Swimnato/SplitKeyboard/README.md

# SplitKeyboard
Split keyboard with rotary encoder using the Nice!Nano V2
