Swimnato/SplitKeyboard/simulation_image_bottom V1.png

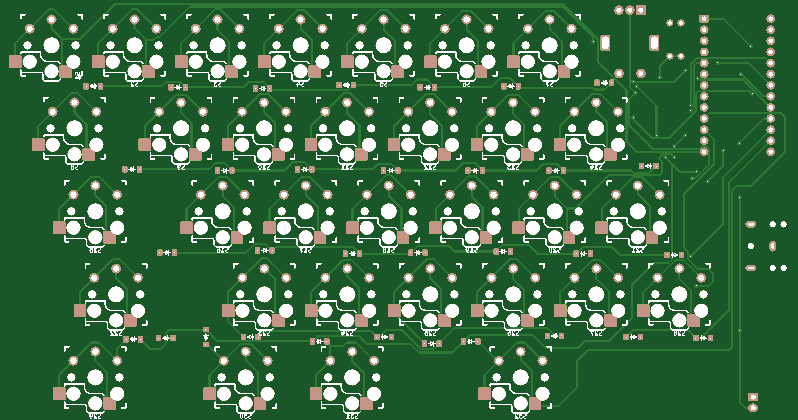
simulation_image_bottom V1.png
