Swimnato/SplitKeyboard/simulation_image_bottom V2.png

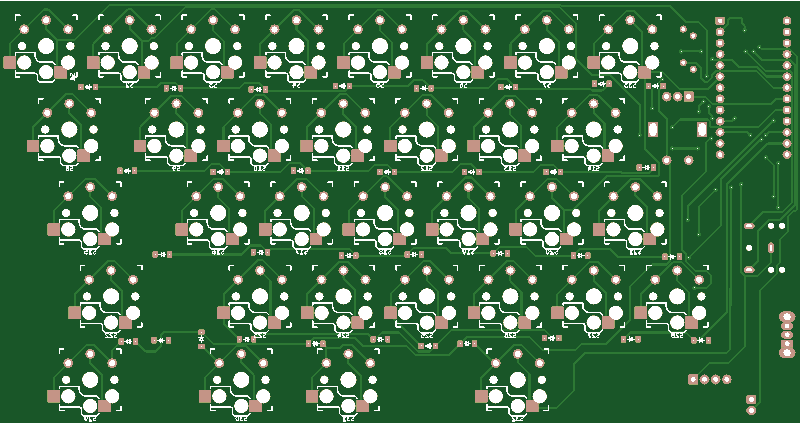
simulation_image_bottom V2.png
