Swimnato/SplitKeyboard/simulation_image_top V1.png

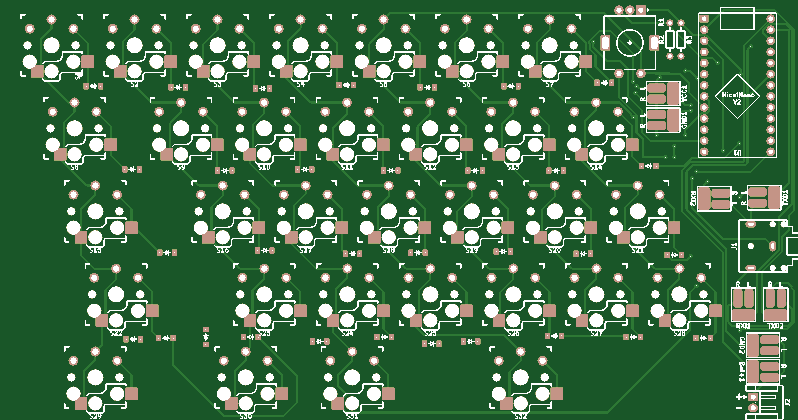
simulation_image_top V1.png
