Swimnato/SplitKeyboard/simulation_image_top V2.png

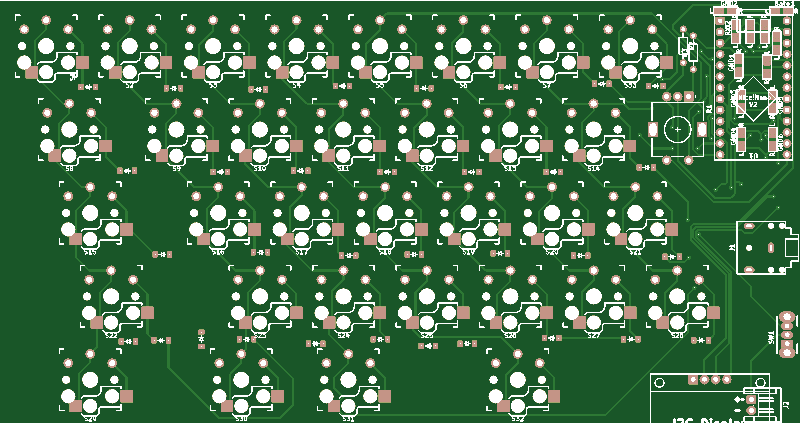
simulation_image_top V2.png
