Swimnato/SplitKeyboard/Parts List.xlsx

Pieces for my Custom Keyboard
Part | Quantity | Link | Price: | Alt Link | Price: | Alt-Alt Link | Price: | Notes
Hot swap Sockets | > 68 to be safe | https://www.amazon.com/DUROCK-Mechanical-Keyboard-Switches-Hot-Swap/dp/B0B4W9YMGM | 13.99 (Pack of 110) |  |  |  |  | You can order these in bulk with the rest of the club, they are the same footprint
Nice!Nano V2 W/ Bluetooth | 2 | https://www.amazon.com/AITRIP-Development-Bluetooth-Management-Module%EF%BC%8CNano/dp/B0DCZJKYL1?s=electronics | 15.99 (Pack of 2) | https://www.amazon.com/AITRIP-Development-Bluetooth-Management-Module%EF%BC%8CNano/dp/B0DCZM8DS9?s=electronics | 21.99 (Pack of 4) | https://www.ebay.com/itm/335573108896?_skw=NRF52840&itmmeta=01JBGAV2F2A7GKGRMNT59WB6JM | 5.63 | It is cheaper on ebay, though the 4 pack on amazon is a little cheaper, so if someone else is using a pro micro compatible pinout they could use this as a drop in replacement so that shipping is fast and we keep costs down, if not ebay from china is sometimes a gamble on how long it takes, or the two pack from amazon is a few dollars more, and is the same site
Diodes | > 69 to be safe | https://www.digikey.com/en/products/detail/onsemi/1N4148TR/9356376 | 0.015 (1.5 cents) |  |  |  |  | Just get me whatever the club is getting, for a pack of 1,000 here on digikey they are like 1.5 ¢ a pop and they are through-hole and will be less of a headache to solder.
Audio Jack | 2 | https://www.amazon.com/uxcell-6-35mm-Headphone-Stereo-Socket/dp/B00X77SUJQ?s=electronics | 6.99 (Pack of 10) |  |  |  |  | I think this is the right footprint… I just used what Carter told me to use, so maybe it would be best to consult with him about this piece…
Power Switch | 2 | https://www.amazon.com/Uxcell-a15080400ux1036-Position-Switch-0-28000000000000003/dp/B0159MD4LU | 9.90 (Pack of 10) | https://www.ebay.com/itm/323745283211?_skw=spdt+switch+slide+horizontal&itmmeta=01JBGBPVZ60JGZ255SN21QV7CC | 6.19 (Pack of 20) |  |  | Just a side-mounted slider switch. I decided to go with through hole, and carter chose SMD, so this part matters.
JST Connector for Battery | 2 | https://www.ebay.com/itm/335543114318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 | 1.99 (Pack of 20) |  |  |  |  | Just whatever Carter is using for the rest. No amazon link for this one, because they, like the diodes on amazon only have variety packs, they are not sold individually.
Rotary Encoder | 2 | https://www.amazon.com/DIYhz-Rotary-Encoder-Digital-Potentiometer/dp/B07D3DF8TK?cv_ct_cx=rotary+encoder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 | 10.99 (Pack of 10) | https://www.ebay.com/itm/203080834192?_skw=rotary+encoder&itmmeta=01JBGC89KK99RV9GBNWEZ2VFHP&var=503312093055 | 2.70 (Pack of 5) |  |  | Regular old Rotary encoder, 10 pack from amazon if others are using them too, if not then ebay is probably better.
Knob for Rotary Encoder | 2 | https://www.ebay.com/itm/126592891723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 | 1.66 | https://www.ebay.com/itm/134047196263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 | 2.69 (Pack of 10) | https://www.amazon.com/Aluminum-Electronic-Potentiometer-Diameter-Knobs%EF%BC%8CSwitch/dp/B08GK8GK72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 | 13.99 (Pack of 5)
I2C Display | 1 | https://www.amazon.com/HiLetgo-Serial-128X64-Display-Color/dp/B06XRBTBTB?s=electronics | 6.99 | https://www.ebay.com/itm/235685702270?_skw=ssd+1306&itmmeta=01JBGCYAW0TF2XEKN1HQ1EHMS6&var=535999986417 | 1.92
10K pullup resistors | 2 | https://www.digikey.com/en/products/detail/stackpole-electronics-inc/CF14JT10K0/1741265 | 0.1 |  |  |  |  | Getting them from the ECE shop would also be fine.
Choc Switches | 68 | https://www.amazon.com/Mechanical-Keyboard-switches-Chocolate-Switches/dp/B0DDCG2WJF | 42.99
PCB cost with shipping: | ~$30
SUBTOTAL of switches, PCB and hotswap brackets (Price divided by packs since spare parts can be reused)
81.64
As you can see, this is the bulk of the price! And this doesn't even include a microcontroller, diodes, rotary encoder or anything!
Subtotal of other components (Price divided by packs, because spare parts can be reused)
$20.11
Many of these parts can be purchased from the ECE shop in smaller quantities while maintining the bulk discount, with how the shop works.
The only parts I think will need to be purchased externally will be the Nice!Nanos, I2C Display,Choc Switches, PCB, rotary encoer and knob and Hot
Swap sockets.
