Swimnato/SplitKeyboard/3d Models/Decor Plate.stl

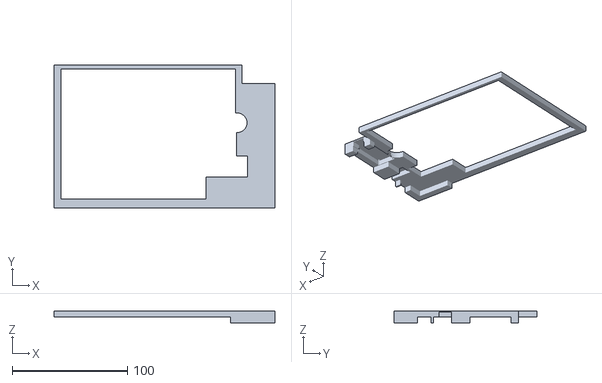
[picture p5: CAD file, 2025-01-26]
3d Models/Decor Plate.stl
191.8 x 124.2 x 10.4
