Swimnato/SplitKeyboard/PCB Bare.stl

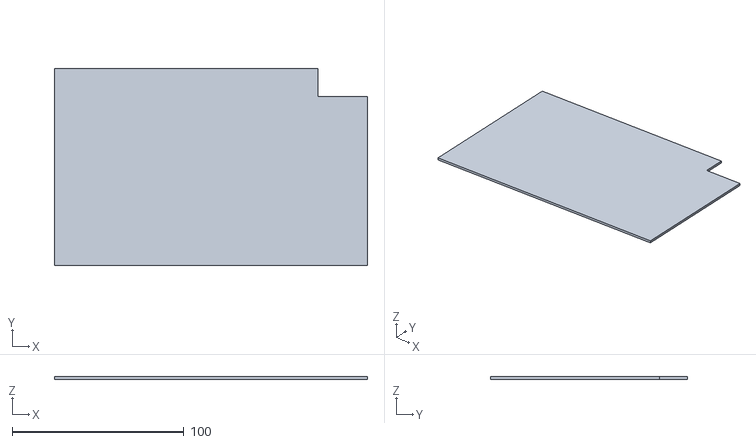
[picture p6: CAD file, 2025-01-17]
PCB Bare.stl
182.1 x 114.5 x 1.60
