Swimnato/SplitKeyboard/3d Models/Keyboard Case.3mf

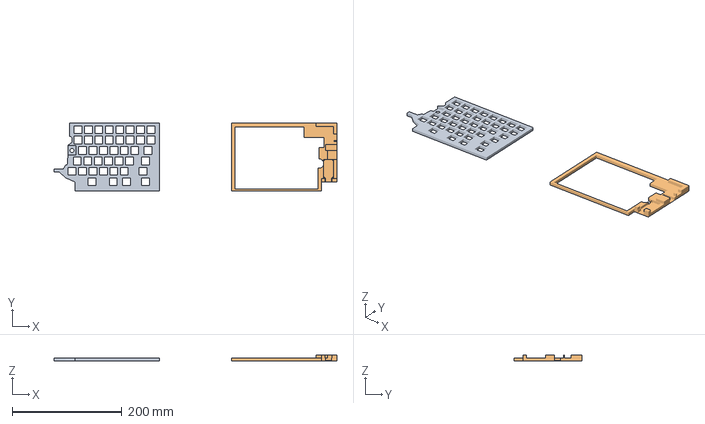
[picture p7: CAD file, 2025-01-26]
3d Models/Keyboard Case.3mf
515.1 x 124.2 x 10.4 mm
Key Plate.stl
Decor Plate.stl
