Swimnato/SplitKeyboard/3d Models/Key Plate.stl

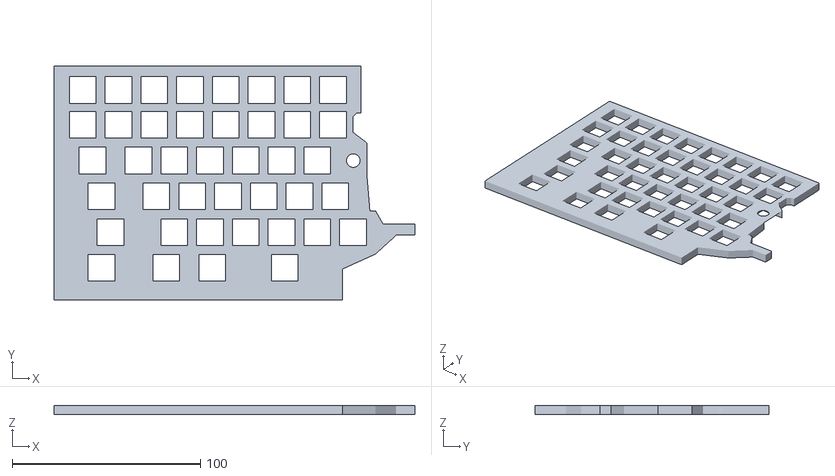
[picture p8: CAD file, 2025-01-26]
3d Models/Key Plate.stl
191.8 x 124.2 x 5.00
