Swimnato/SplitKeyboard/simple_split_MX.step

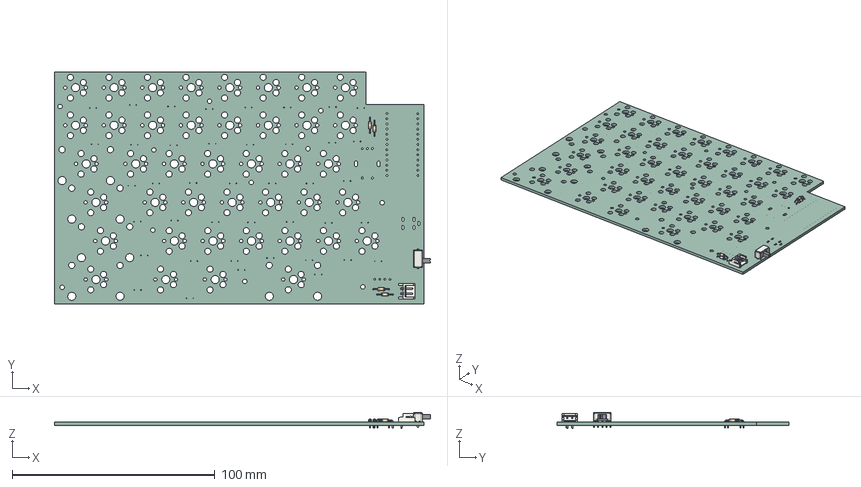
[picture p9: CAD file, 2025-01-17]
simple_split_MX.step
185.3 x 114.5 x 7.90 mm
R_Axial_DIN0204_L36mm_D16mm_P762mm_Horizontal x 4
JST_S2B_EH
SW_Slide_SPDT_Angled_CK_OS102011MA1Q
simple_split_MX_PCB
