Swimnato/SplitKeyboard/3d Models/Bottom Case.stl

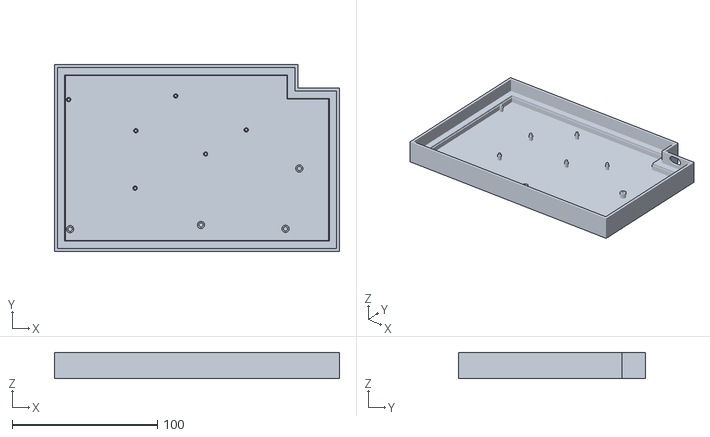
[picture p10: CAD file, 2025-01-17]
3d Models/Bottom Case.stl
196.1 x 128.5 x 18.1
