Swimnato/SplitKeyboard/(list of files, cad)

Other CAD files:
feecad test.FCStd
