Swimnato/SplitKeyboard/simple_split_MX.kicad_pcb

## KiCad design simple_split_MX.kicad_pcb (2024-11-22)

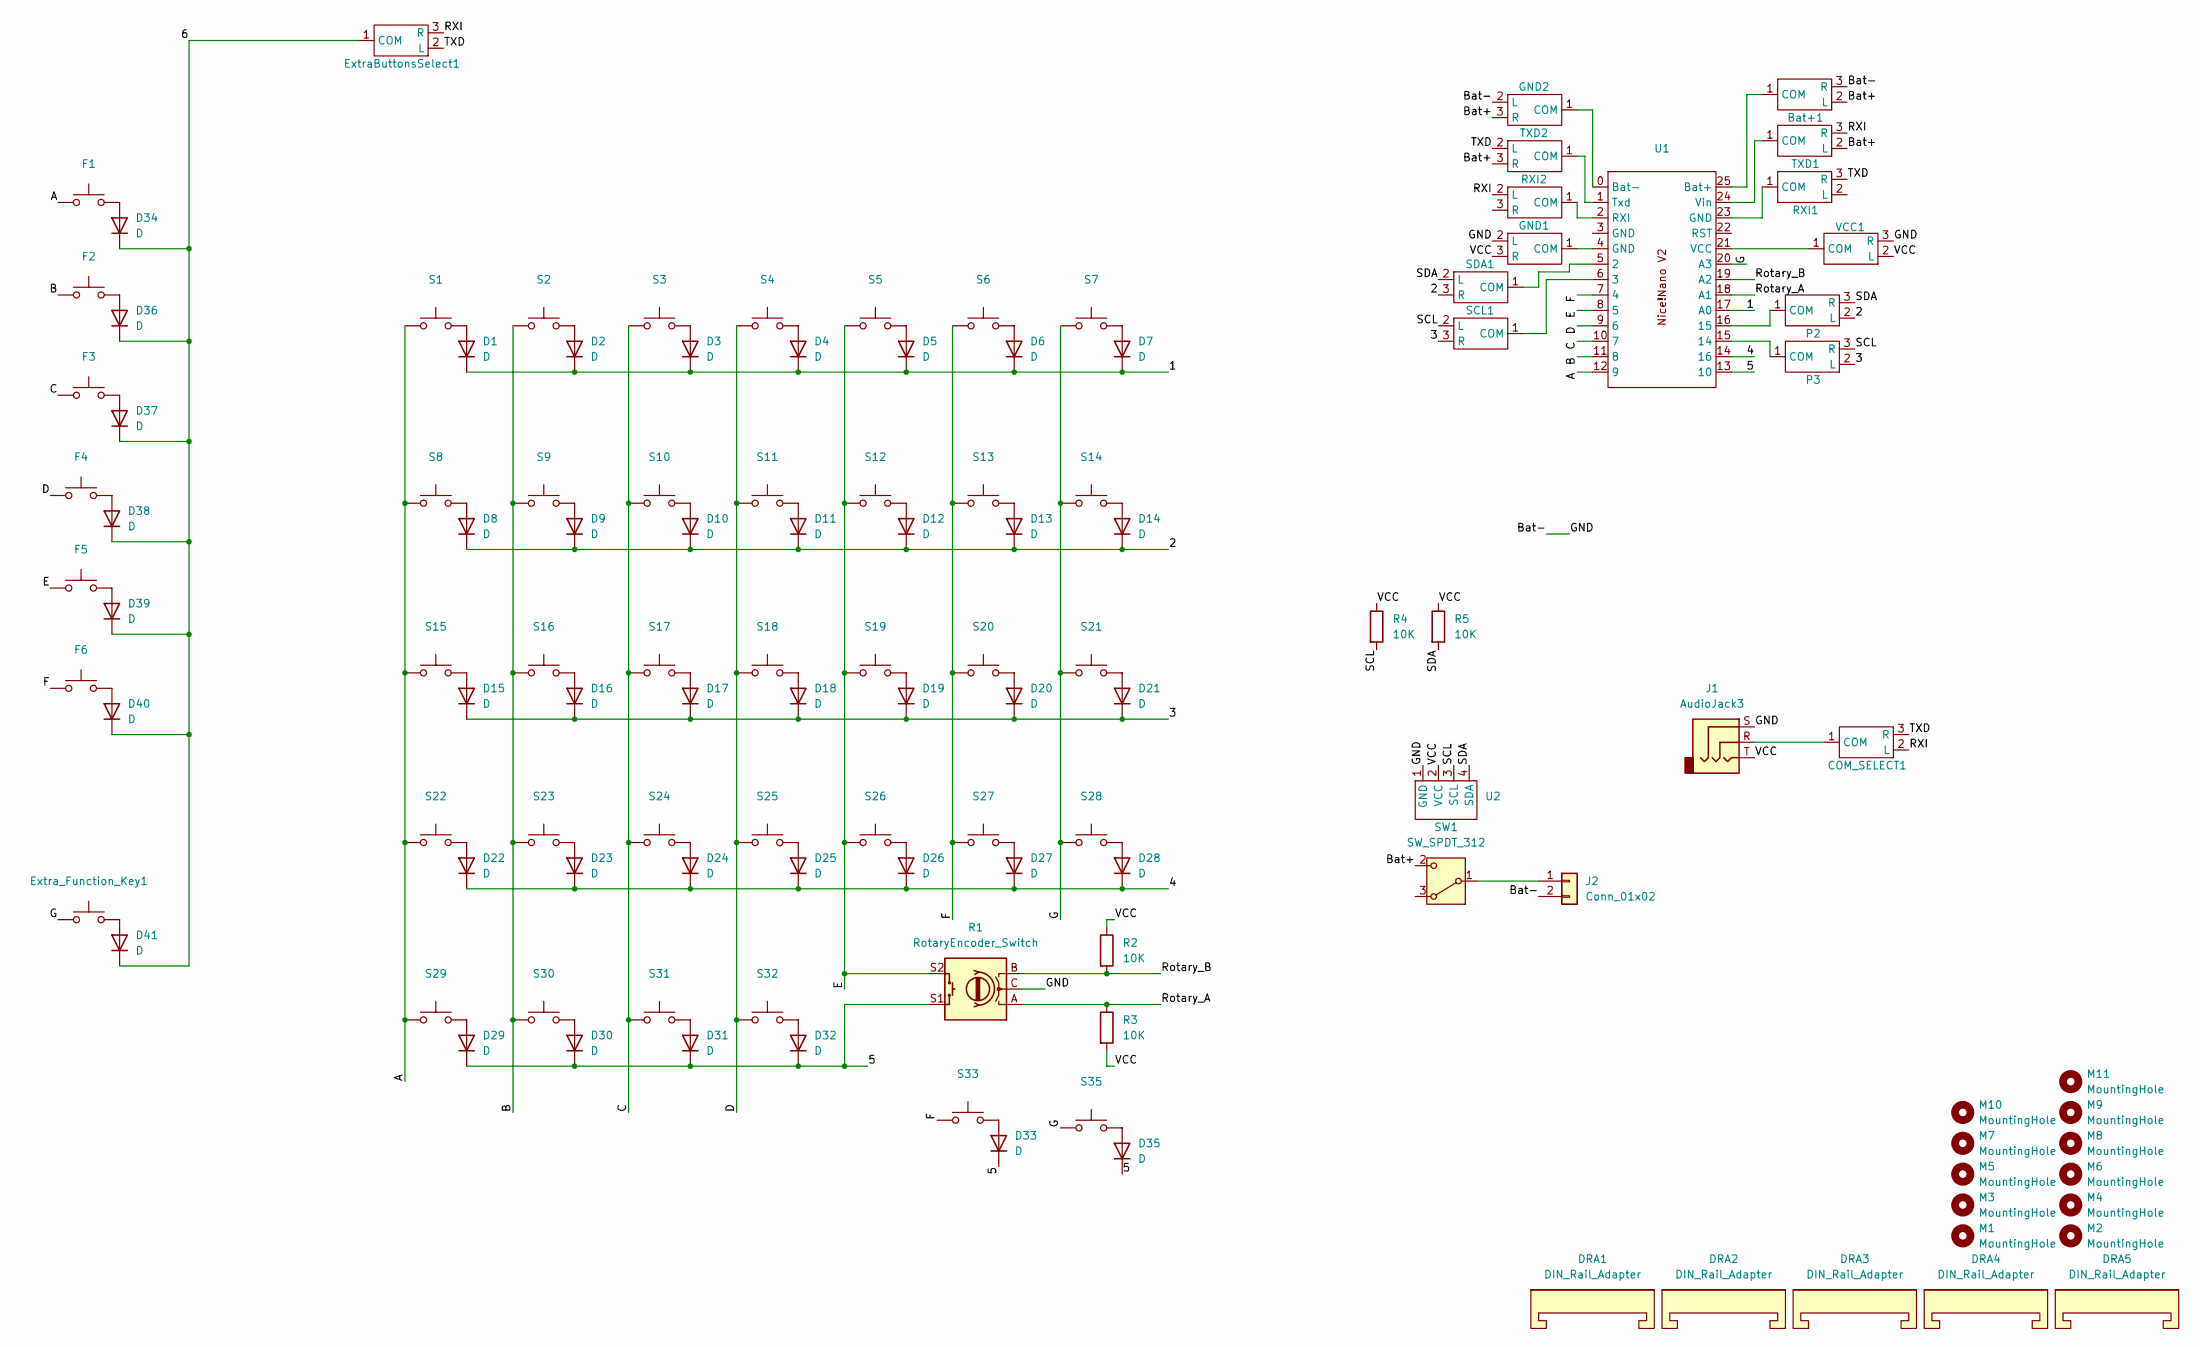
[picture p11: schematic simple_split_MX.kicad_sch]

Parts:
Bat+1: Side Indicator - Improved
COM_SELECT1: Side Indicator - Improved
D1, D2, D3, D4, D5, D6, D7, D8, D9, D10, D11, D12, D13, D14, D15, D16, D17, D18, D19, D20, D21, D22, D23, D24, D25, D26, D27, D28, D29, D30, D31, D32, D33, D34, D35, D36, D37, D38, D39, D40, D41: D; reversable_diode
DRA1, DRA2, DRA3, DRA4, DRA5: DIN_Rail_Adapter; Stabilizer_MX_2u
ExtraButtonsSelect1: Side Indicator - Improved
Extra_Function_Key1: Kailh_socket_MX_reversible
F1, F2, F3, F4, F5, F6: Kailh_socket_MX_reversible
GND1, GND2: Side Indicator - Improved
J1: AudioJack3; Jack_3.5mm_CUI_SJ1-3533NG_Horizontal Reversable
J2: Conn_01x02; JST_EH_S2B-EH_1x02_P2.50mm_Horizontal
M1, M2, M3, M4, M5, M6, M7, M8, M9, M10, M11: MountingHole; MountingHole_2.2mm_M2
P2, P3: Side Indicator - Improved
R1: RotaryEncoder_Switch; RotaryEncoder_Alps_EC11E-Switch_Vertical_H20mm
R2, R3, R4, R5: 10K; R_Axial_DIN0204_L3.6mm_D1.6mm_P7.62mm_Horizontal
RXI1, RXI2: Side Indicator - Improved
S1, S2, S3, S4, S5, S6, S7, S8, S9, S10, S11, S12, S13, S14, S15, S16, S17, S18, S19, S20, S21, S22, S23, S24, S25, S26, S27, S28, S29, S30, S31, S32, S33, S35: Kailh_socket_MX_reversible
SCL1: Side Indicator - Improved
SDA1: Side Indicator - Improved
SW1: SW_SPDT_312; SW_Slide_SPDT_Angled_CK_OS102011MA1Q
TXD1, TXD2: Side Indicator - Improved
U1: Nice!NanoV2
U2: Screen
VCC1: Side Indicator - Improved

Connections:
/1: D1.1 (K), D2.1 (K), D3.1 (K), D4.1 (K), D5.1 (K), D6.1 (K), D7.1 (K), U1.17 (A0)
/2: D8.1 (K), D9.1 (K), D10.1 (K), D11.1 (K), D12.1 (K), D13.1 (K), D14.1 (K), P2.2 (L), SDA1.3 (R)
/3: D15.1 (K), D16.1 (K), D17.1 (K), D18.1 (K), D19.1 (K), D20.1 (K), D21.1 (K), P3.2 (L), SCL1.3 (R)
/4: D22.1 (K), D23.1 (K), D24.1 (K), D25.1 (K), D26.1 (K), D27.1 (K), D28.1 (K), U1.14 (16)
/5: D29.1 (K), D30.1 (K), D31.1 (K), D32.1 (K), D33.1 (K), D35.1 (K), R1.S1, U1.13 (10)
/6: D34.1 (K), D36.1 (K), D37.1 (K), D38.1 (K), D39.1 (K), D40.1 (K), D41.1 (K), ExtraButtonsSelect1.1 (COM)
/A: F1.1 (A), S1.1 (A), S8.1 (A), S15.1 (A), S22.1 (A), S29.1 (A), U1.12 (9)
/B: F2.1 (A), S2.1 (A), S9.1 (A), S16.1 (A), S23.1 (A), S30.1 (A), U1.11 (8)
/Bat+: Bat+1.2 (L), GND2.3 (R), SW1.2 (C), TXD1.2 (L), TXD2.3 (R)
/Bat-: Bat+1.3 (R), GND1.2 (L), GND2.2 (L), J1.S, J2.2, R1.C, U2.1 (GND), VCC1.3 (R)
/C: F3.1 (A), S3.1 (A), S10.1 (A), S17.1 (A), S24.1 (A), S31.1 (A), U1.10 (7)
/D: F4.1 (A), S4.1 (A), S11.1 (A), S18.1 (A), S25.1 (A), S32.1 (A), U1.9 (6)
/E: F5.1 (A), R1.S2, S5.1 (A), S12.1 (A), S19.1 (A), S26.1 (A), U1.8 (5)
/F: F6.1 (A), S6.1 (A), S13.1 (A), S20.1 (A), S27.1 (A), S33.1 (A), U1.7 (4)
/G: Extra_Function_Key1.1 (A), S7.1 (A), S14.1 (A), S21.1 (A), S28.1 (A), S35.1 (A), U1.20 (A3)
/RXI: COM_SELECT1.2 (L), ExtraButtonsSelect1.3 (R), RXI2.2 (L), TXD1.3 (R)
/Rotary_A: R1.A, R3.1, U1.18 (A1)
/Rotary_B: R1.B, R2.2, U1.19 (A2)
/SCL: P3.3 (R), R4.2, SCL1.2 (L), U2.3 (SCL)
/SDA: P2.3 (R), R5.2, SDA1.2 (L), U2.4 (SDA)
/TXD: COM_SELECT1.3 (R), ExtraButtonsSelect1.2 (L), RXI1.3 (R), TXD2.2 (L)
/VCC: GND1.3 (R), J1.T, R2.1, R3.2, R4.1, R5.1, U2.2 (VCC), VCC1.2 (L)
unnamed: Bat+1.1 (COM), U1.25 (Bat+)
unnamed: COM_SELECT1.1 (COM), J1.R
unnamed: D1.2 (A), S1.2 (B)
unnamed: D2.2 (A), S2.2 (B)
unnamed: D3.2 (A), S3.2 (B)
unnamed: D4.2 (A), S4.2 (B)
unnamed: D5.2 (A), S5.2 (B)
unnamed: D6.2 (A), S6.2 (B)
unnamed: D7.2 (A), S7.2 (B)
unnamed: D8.2 (A), S8.2 (B)
unnamed: D9.2 (A), S9.2 (B)
unnamed: D10.2 (A), S10.2 (B)
unnamed: D11.2 (A), S11.2 (B)
unnamed: D12.2 (A), S12.2 (B)
unnamed: D13.2 (A), S13.2 (B)
unnamed: D14.2 (A), S14.2 (B)
unnamed: D15.2 (A), S15.2 (B)
unnamed: D16.2 (A), S16.2 (B)
unnamed: D17.2 (A), S17.2 (B)
unnamed: D18.2 (A), S18.2 (B)
unnamed: D19.2 (A), S19.2 (B)
unnamed: D20.2 (A), S20.2 (B)
unnamed: D21.2 (A), S21.2 (B)
unnamed: D22.2 (A), S22.2 (B)
unnamed: D23.2 (A), S23.2 (B)
unnamed: D24.2 (A), S24.2 (B)
unnamed: D25.2 (A), S25.2 (B)
unnamed: D26.2 (A), S26.2 (B)
unnamed: D27.2 (A), S27.2 (B)
unnamed: D28.2 (A), S28.2 (B)
unnamed: D29.2 (A), S29.2 (B)
unnamed: D30.2 (A), S30.2 (B)
unnamed: D31.2 (A), S31.2 (B)
unnamed: D32.2 (A), S32.2 (B)
unnamed: D33.2 (A), S33.2 (B)
unnamed: D34.2 (A), F1.2 (B)
unnamed: D35.2 (A), S35.2 (B)
unnamed: D36.2 (A), F2.2 (B)
unnamed: D37.2 (A), F3.2 (B)
unnamed: D38.2 (A), F4.2 (B)
unnamed: D39.2 (A), F5.2 (B)
unnamed: D40.2 (A), F6.2 (B)
unnamed: D41.2 (A), Extra_Function_Key1.2 (B)
unnamed: GND1.1 (COM), U1.4 (GND)
unnamed: GND2.1 (COM), U1.0 (Bat-)
unnamed: J2.1, SW1.1 (B)
unnamed: P2.1 (COM), U1.16 (15)
unnamed: P3.1 (COM), U1.15 (14)
unnamed: RXI1.1 (COM), U1.23 (GND)
unnamed: RXI2.1 (COM), U1.2 (RXI)
unnamed: SCL1.1 (COM), U1.6 (3)
unnamed: SDA1.1 (COM), U1.5 (2)
unnamed: TXD1.1 (COM), U1.24 (Vin)
unnamed: TXD2.1 (COM), U1.1 (Txd)
unnamed: U1.21 (VCC), VCC1.1 (COM)

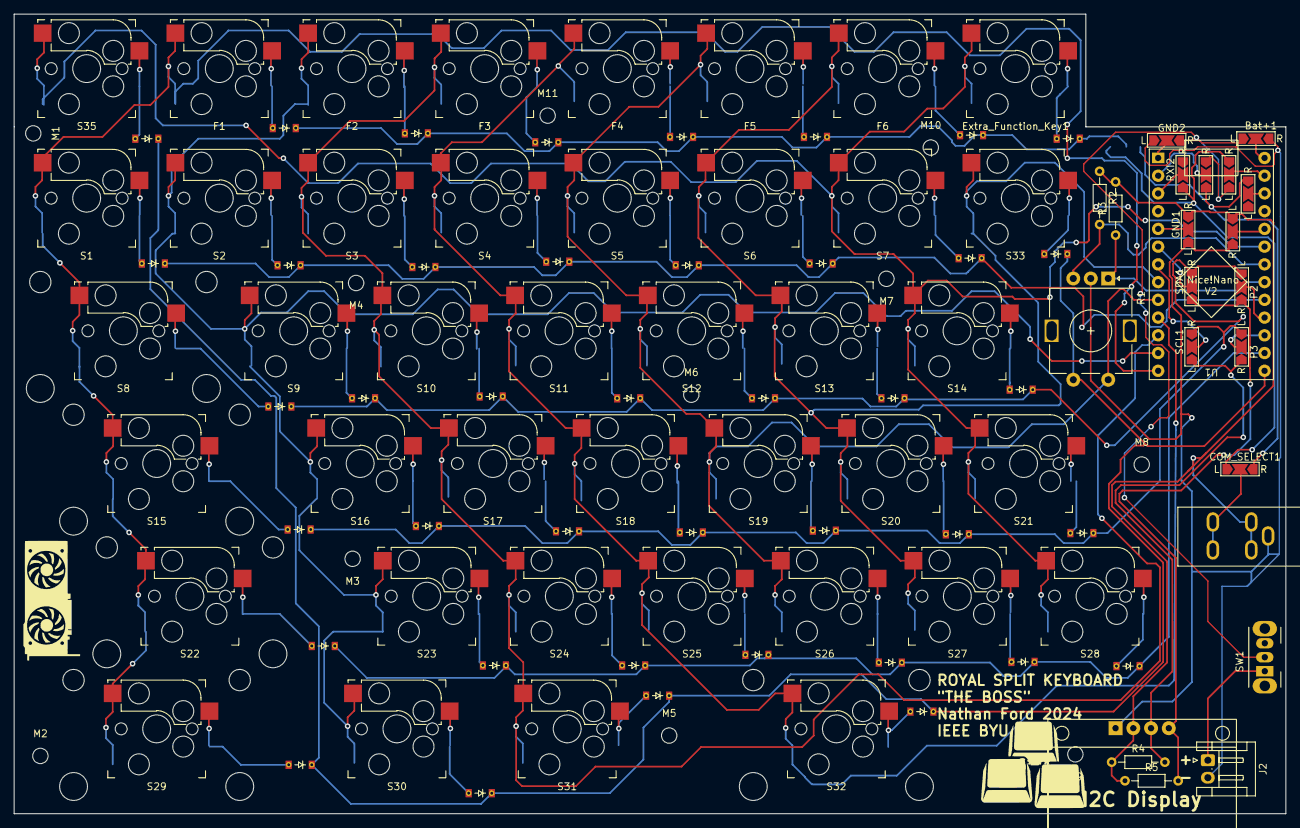
[picture p12: board simple_split_MX.kicad_pcb from above]

Board: 2 copper layers, 182.1 x 114.5 mm, 122 parts (1 on the bottom side), 77 nets.
