Swimnato/SplitKeyboard/(commit log)

2024-11-03 added 7 keys
    14 in total between two sides
    -F1-12
    -2 multipurpose
    [simple_split.kicad_pcb]
2024-11-03 Finished V6
    [simple_split-B_Cu.gbr, simple_split-B_Mask.gbr, simple_split-B_Paste.gbr, simple_split-B_Silkscreen.gbr, simple_split-Edge_Cuts.gbr, simple_split-F_Cu.gbr, simple_split-F_Mask.gbr, simple_split-F_Paste.gbr]
2024-11-08 Finished Routing for MX switches
    - Ran DRC in KiCad
    - Ran JLDFC and I comply with all but THT to SMD spacing, because the side indication jumpers "aren't ideal" because there could be solder wicking, but I will just be careful when assembling the board. I am more likely to mis solder the wrong side than solder to a tht component.
    [simple_split-B_Cu.gbr, simple_split-B_Mask.gbr, simple_split-B_Paste.gbr, simple_split-B_Silkscreen.gbr, simple_split-F_Cu.gbr, simple_split-F_Mask.gbr, simple_split-F_Paste.gbr, simple_split-F_Silkscreen.gbr]
2024-11-08 updated board to remove unused vias
    [simple_split_MX-B_Cu.gbr, simple_split_MX-B_Mask.gbr, simple_split_MX-B_Paste.gbr, simple_split_MX-B_Silkscreen.gbr, simple_split_MX-Edge_Cuts.gbr, simple_split_MX-F_Cu.gbr, simple_split_MX-F_Mask.gbr, simple_split_MX-F_Paste.gbr]
2024-11-08 Fixed exposed trace
    [simple_split_MX-B_Cu.gbr, simple_split_MX-B_Mask.gbr, simple_split_MX-B_Paste.gbr, simple_split_MX-B_Silkscreen.gbr, simple_split_MX-Edge_Cuts.gbr, simple_split_MX-F_Cu.gbr, simple_split_MX-F_Mask.gbr, simple_split_MX-F_Paste.gbr]
2024-11-14 added custom silkscreen
    [Parts List.xlsx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]
2024-11-15 added a new Image
    [simple_split-B_Cu.gbr, simple_split-B_Mask.gbr, simple_split-B_Paste.gbr, simple_split-B_Silkscreen.gbr, simple_split-Edge_Cuts.gbr, simple_split-F_Cu.gbr, simple_split-F_Mask.gbr, simple_split-F_Paste.gbr]
2024-11-21 fixed major problem
    [simple_split-B_Cu.gbr, simple_split-B_Mask.gbr, simple_split-B_Paste.gbr, simple_split-B_Silkscreen.gbr, simple_split-Edge_Cuts.gbr, simple_split-F_Cu.gbr, simple_split-F_Mask.gbr, simple_split-F_Paste.gbr]
2024-11-21 fixed problem
    [simple_split_MX-B_Cu.gbr, simple_split_MX-B_Mask.gbr, simple_split_MX-B_Paste.gbr, simple_split_MX-B_Silkscreen.gbr, simple_split_MX-Edge_Cuts.gbr, simple_split_MX-F_Cu.gbr, simple_split_MX-F_Mask.gbr, simple_split_MX-F_Paste.gbr]
2024-11-22 updated pcb
    [simple_split_MX-B_Cu.gbr, simple_split_MX-B_Mask.gbr, simple_split_MX-B_Paste.gbr, simple_split_MX-B_Silkscreen.gbr, simple_split_MX-Edge_Cuts.gbr, simple_split_MX-F_Cu.gbr, simple_split_MX-F_Mask.gbr, simple_split_MX-F_Paste.gbr]
2025-01-17 cleaning up a bit
    [Bottom Case.stl, PCB Bare.stl, Parts List.xlsx, feecad test.FCStd, simple_split_MX.step]
2025-01-26 added/updated 3d files
    [Decor Plate.stl, Key Plate.stl, Keyboard Case.3mf]
2025-02-02 added labels
    [simple_split.kicad_sch]
